BLVD3/MecanumControllerPCB/MecanumDevBoard.kicad_pcb

## KiCad design MecanumDevBoard.kicad_pcb (2023-12-19)

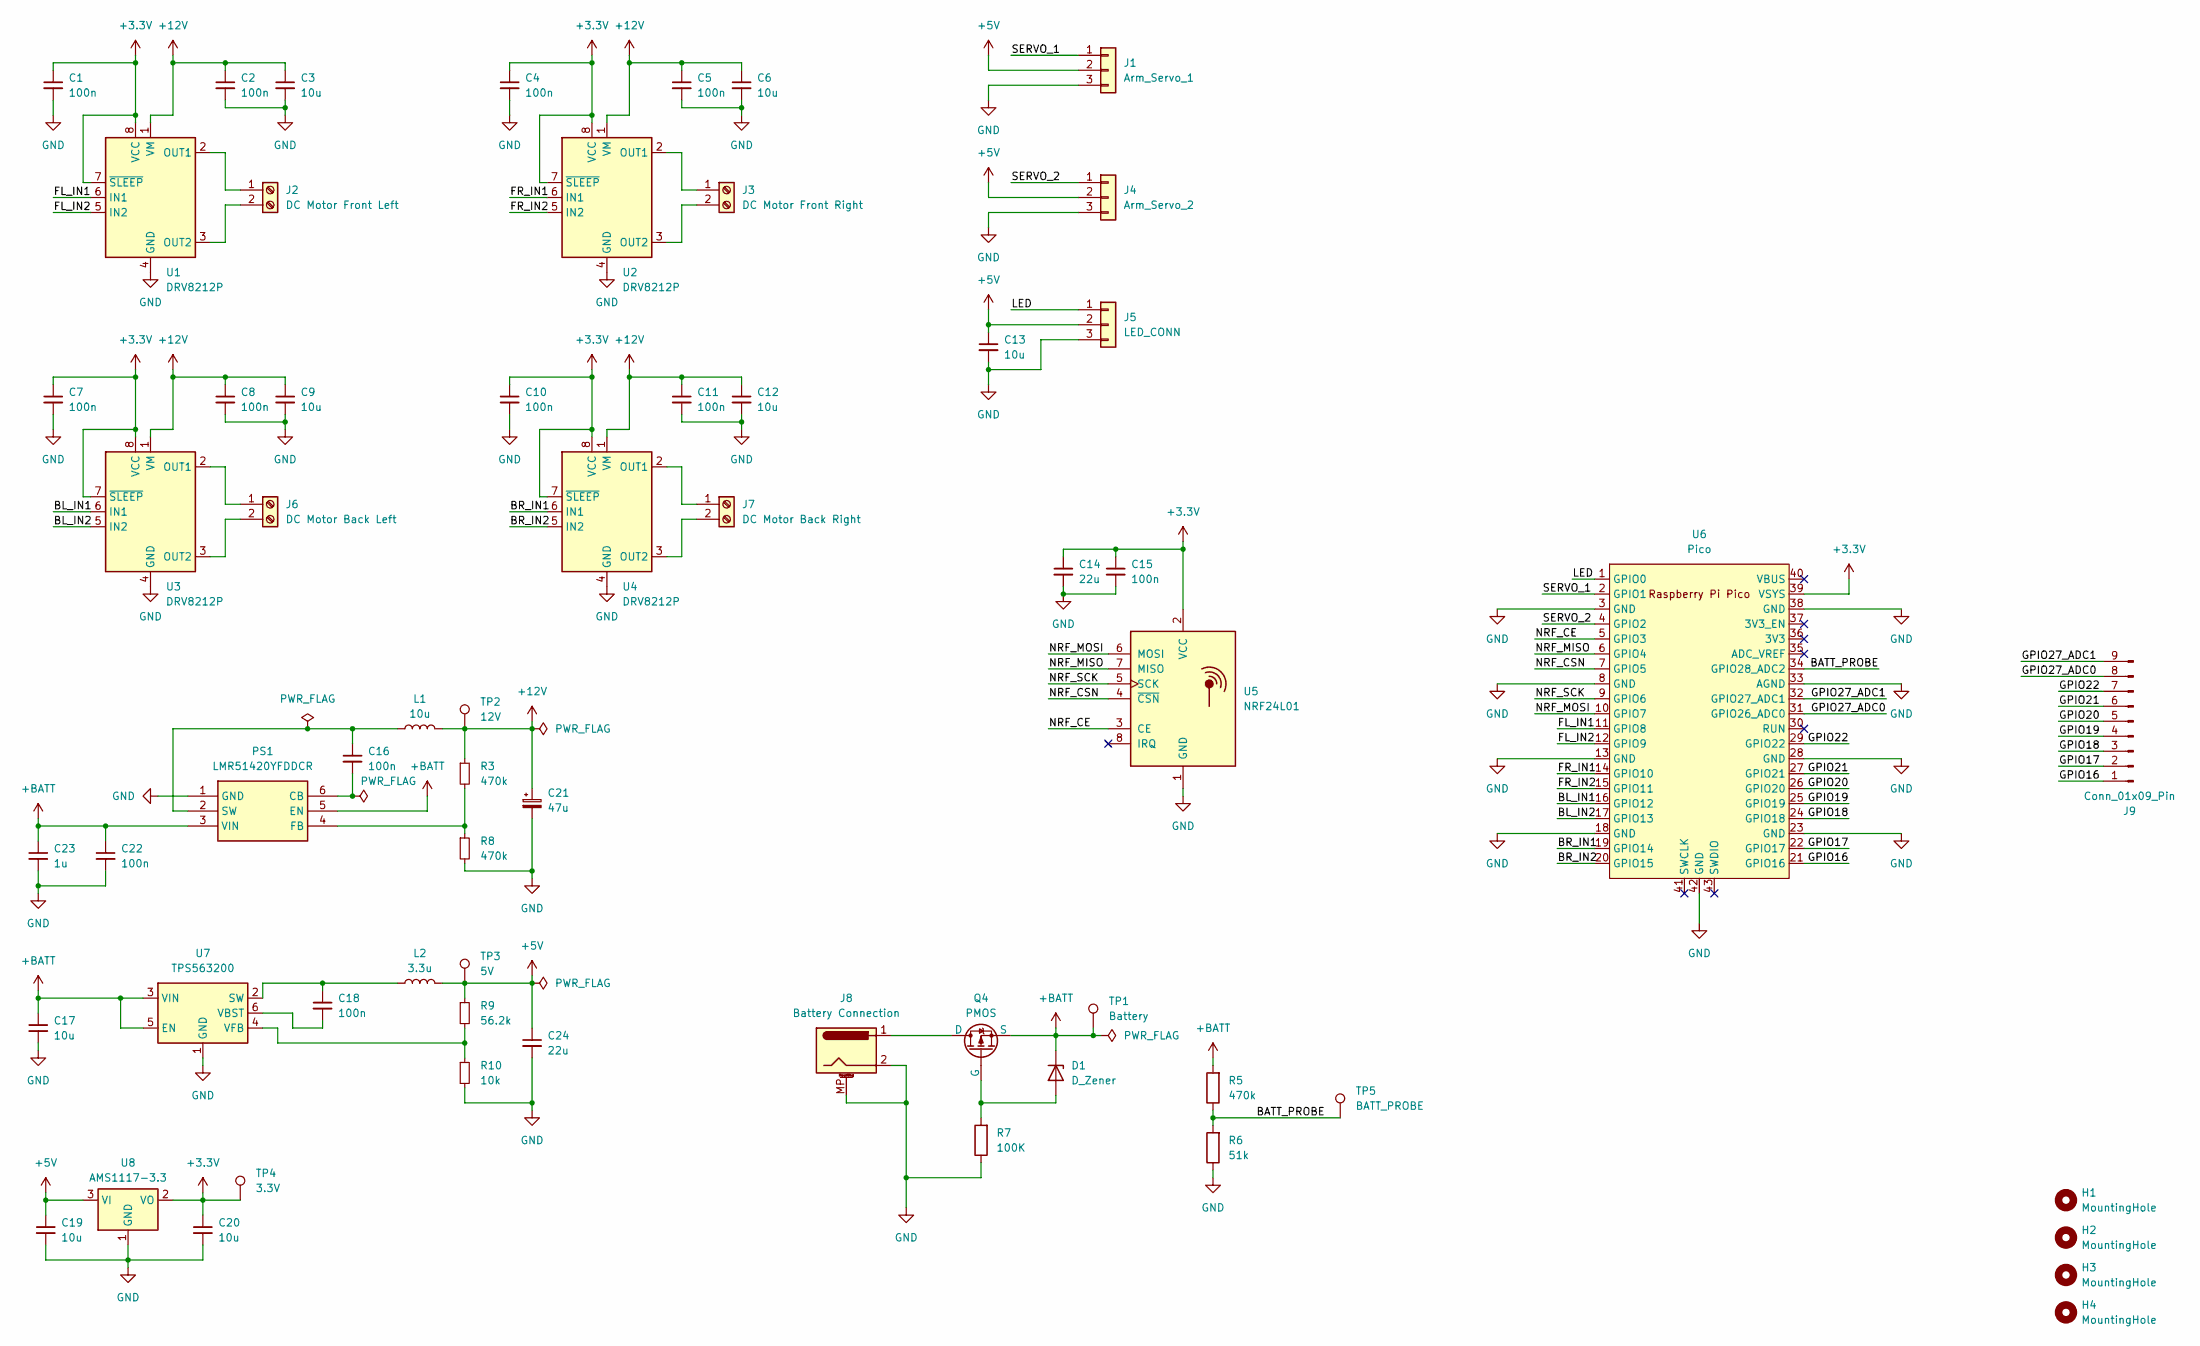
[picture p1: schematic MecanumDevBoard.kicad_sch, MecanumDrone]

Parts:
C1, C2, C4, C5, C7, C8, C10, C11, C15, C16, C18, C22: 100n; C_0603_1608Metric
C3, C6, C9, C12, C13, C17, C19, C20: 10u; C_0805_2012Metric
C14, C24: 22u; C_0805_2012Metric
C21: 47u; CP_Radial_D8.0mm_P5.00mm
C23: 1u; C_0603_1608Metric
D1: D_Zener; D_SOD-123
H1, H2, H3, H4: MountingHole; MountingHole_2.2mm_M2
J1: Arm_Servo_1; PinHeader_1x03_P2.54mm_Vertical
J2: DC Motor Front Left; TerminalBlock_Phoenix_MPT-0,5-2-2.54_1x02_P2.54mm_Horizontal
J3: DC Motor Front Right; TerminalBlock_Phoenix_MPT-0,5-2-2.54_1x02_P2.54mm_Horizontal
J4: Arm_Servo_2; PinHeader_1x03_P2.54mm_Vertical
J5: LED_CONN; PinHeader_1x03_P2.54mm_Vertical
J6: DC Motor Back Left; TerminalBlock_Phoenix_MPT-0,5-2-2.54_1x02_P2.54mm_Horizontal
J7: DC Motor Back Right; TerminalBlock_Phoenix_MPT-0,5-2-2.54_1x02_P2.54mm_Horizontal
J8: Battery Connection; BarrelJack_Horizontal
J9: Conn_01x09_Pin; PinHeader_1x09_P2.54mm_Vertical
L1: 10u; L_Bourns-SRN6028
L2: 3.3u; L_Bourns-SRN6028
PS1: LMR51420YFDDCR; SOT95P280X110-6N; Manufacturer_Part_Number LMR51420YFDDCR; Mouser Part Number 595-LMR51420YFDDCR
Q4: PMOS; SOT-23
R3, R5, R8: 470k; R_0805_2012Metric
R6: 51k; R_0603_1608Metric
R7: 100K; R_0805_2012Metric
R9: 56.2k; R_0603_1608Metric
R10: 10k; R_0805_2012Metric
TP1: Battery; TestPoint_Pad_D1.0mm
TP2: 12V; TestPoint_Pad_D1.0mm
TP3: 5V; TestPoint_Pad_D1.0mm
TP4: 3.3V; TestPoint_Pad_D1.0mm
TP5: BATT_PROBE; TestPoint_Pad_D1.0mm
U1, U2, U3, U4: DRV8212P; WSON-8-1EP_2x2mm_P0.5mm_EP0.9x1.6mm
U5: NRF24L01; nRF24L01_Breakout
U6: Pico; RPi_Pico_SMD_TH
U7: TPS563200; SOT-23-6
U8: AMS1117-3.3; SOT-223-3_TabPin2

Connections:
+3.3V: C1.1, C4.1, C7.1, C10.1, C14.1, C15.1, C20.1, TP4.1, U1.7 (~SLEEP), U1.8 (VCC), U2.7 (~SLEEP), U2.8 (VCC), U3.7 (~SLEEP), U3.8 (VCC), U4.7 (~SLEEP), U4.8 (VCC), U5.2 (VCC), U6.39 (VSYS), U8.2 (VO)
+5V: C13.1, C19.1, C24.1, J1.2, J4.2, J5.2, L2.2, R9.1, TP3.1, U8.3 (VI)
+12V: C2.1, C3.1, C5.1, C6.1, C8.1, C9.1, C11.1, C12.1, C21.1, L1.2, R3.1, TP2.1, U1.1 (VM), U2.1 (VM), U3.1 (VM), U4.1 (VM)
+BATT: C17.1, C22.1, C23.1, D1.1 (K), PS1.3 (VIN), PS1.5 (EN), Q4.3 (S), R5.2, TP1.1, U7.3 (VIN), U7.5 (EN)
/BATT_PROBE: R5.1, R6.2, TP5.1, U6.34 (GPIO28_ADC2)
/BL_IN1: U3.6 (IN1), U6.16 (GPIO12)
/BL_IN2: U3.5 (IN2), U6.17 (GPIO13)
/BR_IN1: U4.6 (IN1), U6.19 (GPIO14)
/BR_IN2: U4.5 (IN2), U6.20 (GPIO15)
/FL_IN1: U1.6 (IN1), U6.11 (GPIO8)
/FL_IN2: U1.5 (IN2), U6.12 (GPIO9)
/FR_IN1: U2.6 (IN1), U6.14 (GPIO10)
/FR_IN2: U2.5 (IN2), U6.15 (GPIO11)
/GPIO16: J9.1, U6.21 (GPIO16)
/GPIO17: J9.2, U6.22 (GPIO17)
/GPIO18: J9.3, U6.24 (GPIO18)
/GPIO19: J9.4, U6.25 (GPIO19)
/GPIO20: J9.5, U6.26 (GPIO20)
/GPIO21: J9.6, U6.27 (GPIO21)
/GPIO22: J9.7, U6.29 (GPIO22)
/GPIO27_ADC0: J9.8, U6.31 (GPIO26_ADC0)
/GPIO27_ADC1: J9.9, U6.32 (GPIO27_ADC1)
/LED: J5.1, U6.1 (GPIO0)
/NRF_CE: U5.3 (CE), U6.5 (GPIO3)
/NRF_CSN: U5.4 (~CSN), U6.7 (GPIO5)
/NRF_MISO: U5.7 (MISO), U6.6 (GPIO4)
/NRF_MOSI: U5.6 (MOSI), U6.10 (GPIO7)
/NRF_SCK: U5.5 (SCK), U6.9 (GPIO6)
/SERVO_1: J1.1, U6.2 (GPIO1)
/SERVO_2: J4.1, U6.4 (GPIO2)
GND: C1.2, C2.2, C3.2, C4.2, C5.2, C6.2, C7.2, C8.2, C9.2, C10.2, C11.2, C12.2, C13.2, C14.2, C15.2, C17.2, C19.2, C20.2, C21.2, C22.2, C23.2, C24.2, J1.3, J4.3, J5.3, J8.2, J8.MP (MountPin), PS1.1 (GND), R6.1, R7.1, R8.2, R10.2, U1.4 (GND), U1.9 (GND), U2.4 (GND), U2.9 (GND), U3.4 (GND), U3.9 (GND), U4.4 (GND), U4.9 (GND), U5.1 (GND), U6.3 (GND), U6.8 (GND), U6.13 (GND), U6.18 (GND), U6.23 (GND), U6.28 (GND), U6.33 (AGND), U6.38 (GND), U6.42 (GND), U7.1 (GND), U8.1 (GND)
unnamed: D1.2 (A), Q4.2 (G), R7.2
unnamed: J2.1, U1.2 (OUT1)
unnamed: J2.2, U1.3 (OUT2)
unnamed: J3.1, U2.2 (OUT1)
unnamed: J3.2, U2.3 (OUT2)
unnamed: J6.1, U3.2 (OUT1)
unnamed: J6.2, U3.3 (OUT2)
unnamed: J7.1, U4.2 (OUT1)
unnamed: J7.2, U4.3 (OUT2)
unnamed: C16.2, PS1.6 (CB)
unnamed: PS1.4 (FB), R3.2, R8.1
unnamed: C16.1, L1.1, PS1.2 (SW)
unnamed: J8.1, Q4.1 (D)
unnamed: C18.1, L2.1, U7.2 (SW)
unnamed: C18.2, U7.6 (VBST)
unnamed: R9.2, R10.1, U7.4 (VFB)

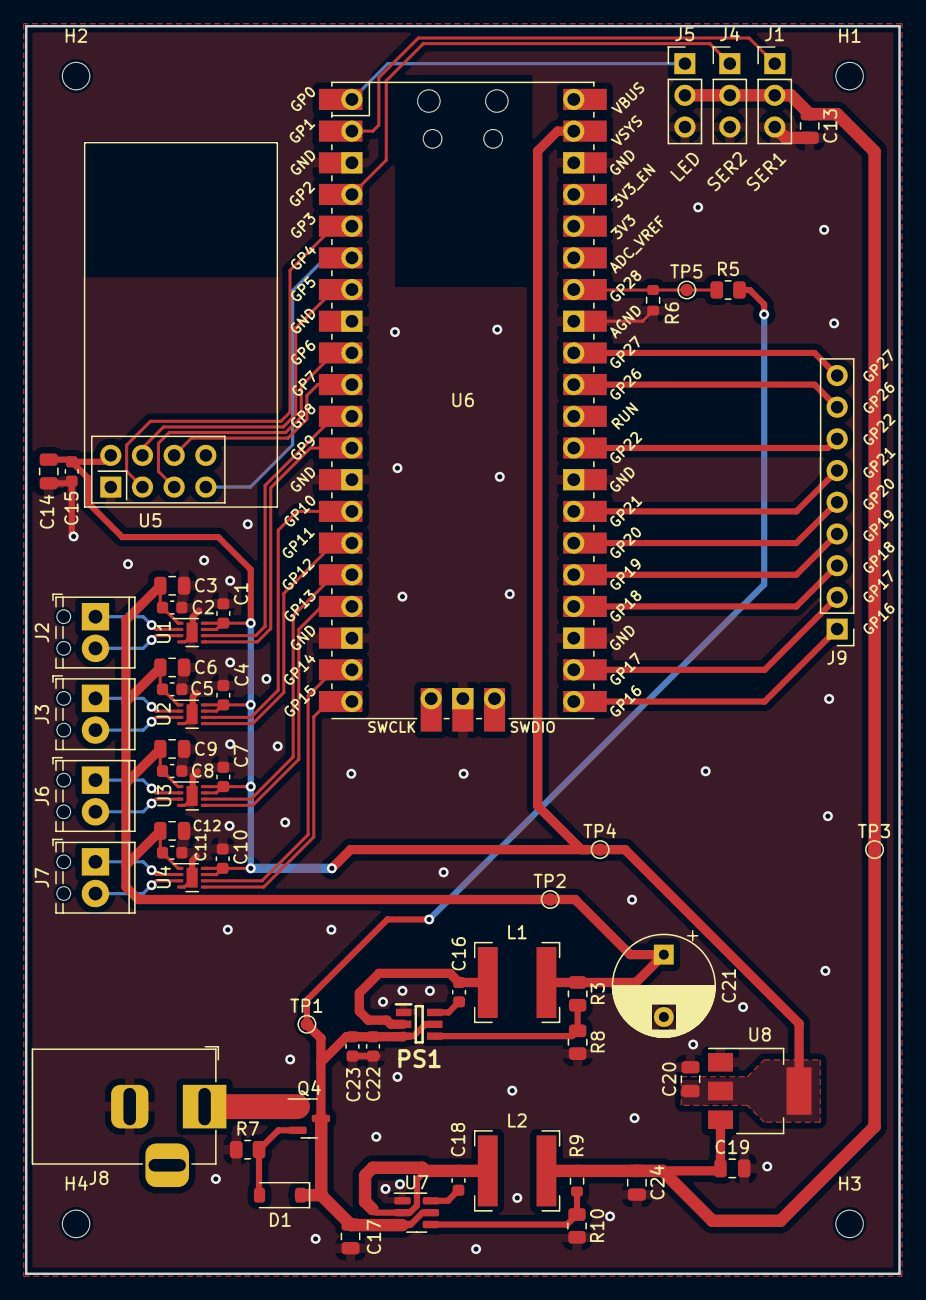
[picture p2: board MecanumDevBoard.kicad_pcb from above]

Board: 2 copper layers, 70.0 x 100.0 mm, 62 parts (0 on the bottom side), 47 nets.
